gppk/EMF-Logo-Broach/Media/BOM Layout 1-crop-annotated.png

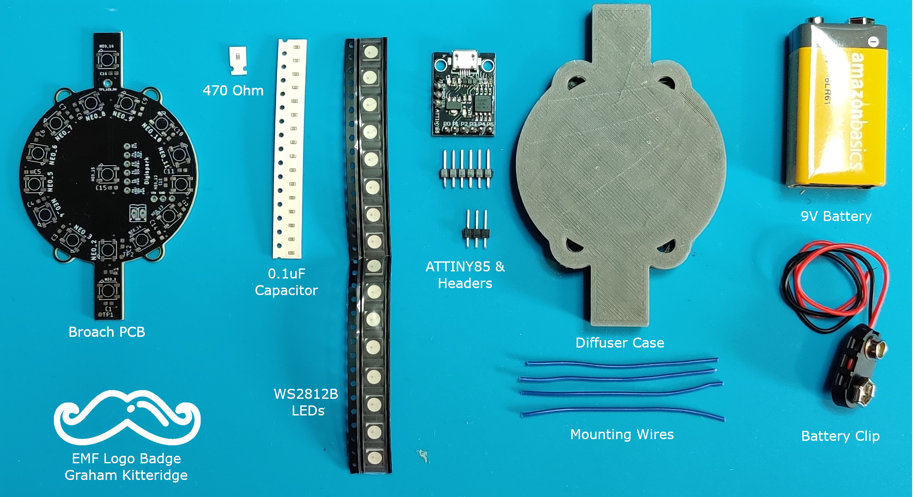
Media/BOM Layout 1-crop-annotated.png
