gppk/EMF-Logo-Broach/Kits/Kit Front Page.docx

EMF Logo Broach

https://blog.gppk.dev/emf-logo-badge-website/

1 | Broach PCB
1 | Broach Diffuser Case
1 | Digispark ATTINY85 & Headers
16 | WS2812B LEDs
16 | 0.1uF Capacitors
1 | 470 Ohm Resistor
1 | 9V Battery & Clip
4 | Mounting Wires
1 | Battery Sticker

EMF Logo Broach

https://blog.gppk.dev/emf-logo-badge-website/

1 | Broach PCB
1 | Broach Diffuser Case
1 | Digispark ATTINY85 & Headers
16 | WS2812B LEDs
16 | 0.1uF Capacitors
1 | 470 Ohm Resistor
1 | 9V Battery & Clip
4 | Mounting Wires
1 | Battery Sticker
