gppk/EMF-Logo-Broach/Hardware/EMF Badge/3D Printing Files/Diffuser Case.3mf

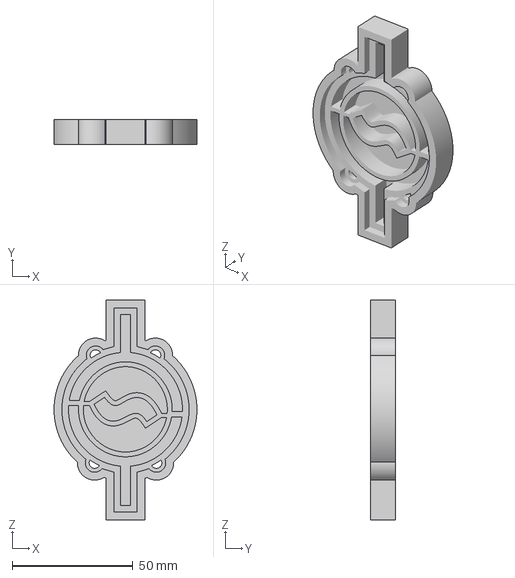
[picture p2: CAD file, 2022-05-13]
Hardware/EMF Badge/3D Printing Files/Diffuser Case.3mf
59.2 x 10.4 x 91.1 mm
