gppk/EMF-Logo-Broach/Hardware/EMF Badge/SolderStencil/pcb-stencil.3mf

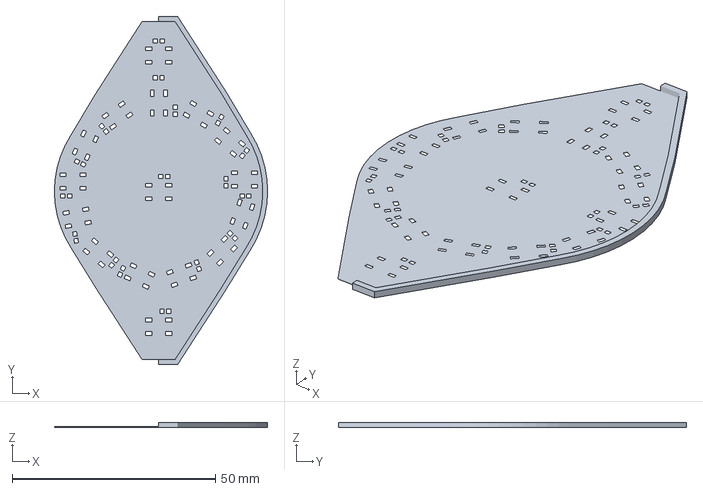
[picture p3: CAD file, 2022-05-13]
Hardware/EMF Badge/SolderStencil/pcb-stencil.3mf
52.4 x 85.5 x 1.20 mm
