gppk/EMF-Logo-Broach/Hardware/EMF Badge/SolderStencil/output.scad

rotate(a = 180, v = [1, 0, 0]) {
	union() {
		translate(v = [0, 0, -1.0000000000]) {
			linear_extrude(height = 1.2000000000) {
				difference() {
					polygon(points = [[20.9095670833, -1.2000000000], [30.3110361963, -1.2000000000], [42.2351863779, 17.3431679693], [48.3139464654, 27.5519898918], [49.7554900733, 30.1405903421], [50.9168166147, 32.9271457313], [51.7526695622, 35.8159708304], [52.2553940713, 38.7778560633], [52.4229252793, 41.7902765977], [52.2449729097, 44.8719929287], [51.7118517315, 47.9031377021], [50.8323147282, 50.8558690704], [49.6160567625, 53.6955488128], [48.1108870351, 56.3308836265], [41.8017726376, 66.5529519559], [41.6639389306, 66.7675195391], [30.3094091234, 84.3440000000], [20.9116971335, 84.3440000000], [9.4566744323, 66.6172726314], [3.0951645725, 56.3410208071], [1.5912865114, 53.7012458143], [0.3781252875, 50.8583244302], [-0.4972944317, 47.9043064544], [-1.0250720793, 44.8727265141], [-1.2019120014, 41.7900613624], [-1.0344018529, 38.7769725647], [-0.5317377234, 35.8123014176], [0.3041027405, 32.9193297869], [1.4666350095, 30.1302996677], [2.9095684429, 27.5420828811], [8.9654270859, 17.4009346347], [9.1044786186, 17.1785859001]]);
					polygon(points = [[21.5650000000, 0.0000000000], [29.6560000000, 0.0000000000], [41.2146915230, 17.9748455992], [47.2740000000, 28.1510000000], [48.6740000000, 30.6650000000], [49.7830000000, 33.3260000000], [50.5810000000, 36.0840000000], [51.0610000000, 38.9120000000], [51.2210000000, 41.7890000000], [51.0510000000, 44.7330000000], [50.5420000000, 47.6270000000], [49.7020000000, 50.4470000000], [48.5400000000, 53.1600000000], [47.0790000000, 55.7180000000], [40.7862936847, 65.9134838475], [40.6551366899, 66.1176577031], [29.6560000000, 83.1440000000], [21.5650000000, 83.1440000000], [10.4708676431, 65.9757529514], [4.1270000000, 55.7280000000], [2.6680000000, 53.1670000000], [1.5090000000, 50.4510000000], [0.6730000000, 47.6300000000], [0.1690000000, 44.7350000000], [0.0000000000, 41.7890000000], [0.1600000000, 38.9110000000], [0.6400000000, 36.0800000000], [1.4380000000, 33.3180000000], [2.5480000000, 30.6550000000], [3.9490000000, 28.1420000000], [9.9893888712, 18.0267574522], [10.1180571636, 17.8210119171]]);
					polygon(points = [[-1.2019120014, -1.2000000000], [-1.2019120014, 84.3440000000], [25.6105066389, 84.3440000000], [25.6105066389, -1.2000000000]]);
				}
			}
		}
		linear_extrude(height = 0.2000000000) {
			difference() {
				polygon(points = [[21.5650000000, 0.0000000000], [29.6560000000, 0.0000000000], [41.2146915230, 17.9748455992], [47.2740000000, 28.1510000000], [48.6740000000, 30.6650000000], [49.7830000000, 33.3260000000], [50.5810000000, 36.0840000000], [51.0610000000, 38.9120000000], [51.2210000000, 41.7890000000], [51.0510000000, 44.7330000000], [50.5420000000, 47.6270000000], [49.7020000000, 50.4470000000], [48.5400000000, 53.1600000000], [47.0790000000, 55.7180000000], [40.7862936847, 65.9134838475], [40.6551366899, 66.1176577031], [29.6560000000, 83.1440000000], [21.5650000000, 83.1440000000], [10.4708676431, 65.9757529514], [4.1270000000, 55.7280000000], [2.6680000000, 53.1670000000], [1.5090000000, 50.4510000000], [0.6730000000, 47.6300000000], [0.1690000000, 44.7350000000], [0.0000000000, 41.7890000000], [0.1600000000, 38.9110000000], [0.6400000000, 36.0800000000], [1.4380000000, 33.3180000000], [2.5480000000, 30.6550000000], [3.9490000000, 28.1420000000], [9.9893888712, 18.0267574522], [10.1180571636, 17.8210119171]]);
				union() {
					polygon(points = [[26.8740000000, 21.8110000000], [26.8740000000, 23.3110000000], [27.7740000000, 23.3110000000], [27.7740000000, 21.8110000000]]);
					polygon(points = [[23.5740000000, 21.8110000000], [23.5740000000, 23.3110000000], [24.4740000000, 23.3110000000], [24.4740000000, 21.8110000000]]);
					polygon(points = [[26.8740000000, 16.9110000000], [26.8740000000, 18.4110000000], [27.7740000000, 18.4110000000], [27.7740000000, 16.9110000000]]);
					polygon(points = [[23.5740000000, 16.9110000000], [23.5740000000, 18.4110000000], [24.4740000000, 18.4110000000], [24.4740000000, 16.9110000000]]);
					polygon(points = [[1.3720000000, 40.5700000000], [1.3720000000, 41.4700000000], [2.8720000000, 41.4700000000], [2.8720000000, 40.5700000000]]);
					polygon(points = [[1.3720000000, 37.2700000000], [1.3720000000, 38.1700000000], [2.8720000000, 38.1700000000], [2.8720000000, 37.2700000000]]);
					polygon(points = [[6.2720000000, 40.5700000000], [6.2720000000, 41.4700000000], [7.7720000000, 41.4700000000], [7.7720000000, 40.5700000000]]);
					polygon(points = [[6.2720000000, 37.2700000000], [6.2720000000, 38.1700000000], [7.7720000000, 38.1700000000], [7.7720000000, 37.2700000000]]);
					polygon(points = [[27.3540000000, 6.2820000000], [27.3540000000, 7.1820000000], [28.8540000000, 7.1820000000], [28.8540000000, 6.2820000000]]);
					polygon(points = [[27.3540000000, 9.5820000000], [27.3540000000, 10.4820000000], [28.8540000000, 10.4820000000], [28.8540000000, 9.5820000000]]);
					polygon(points = [[22.4540000000, 6.2820000000], [22.4540000000, 7.1820000000], [23.9540000000, 7.1820000000], [23.9540000000, 6.2820000000]]);
					polygon(points = [[22.4540000000, 9.5820000000], [22.4540000000, 10.4820000000], [23.9540000000, 10.4820000000], [23.9540000000, 9.5820000000]]);
					polygon(points = [[25.9540000000, 4.3260000000], [25.9540000000, 5.3260000000], [27.0540000000, 5.3260000000], [27.0540000000, 4.3260000000]]);
					polygon(points = [[24.2540000000, 4.3260000000], [24.2540000000, 5.3260000000], [25.3540000000, 5.3260000000], [25.3540000000, 4.3260000000]]);
					polygon(points = [[29.2180000000, 22.2710000000], [29.2180000000, 23.3710000000], [30.2180000000, 23.3710000000], [30.2180000000, 22.2710000000]]);
					polygon(points = [[29.2180000000, 20.5710000000], [29.2180000000, 21.6710000000], [30.2180000000, 21.6710000000], [30.2180000000, 20.5710000000]]);
					polygon(points = [[1.5210000000, 42.4260000000], [1.5210000000, 43.4260000000], [2.6210000000, 43.4260000000], [2.6210000000, 42.4260000000]]);
					polygon(points = [[3.2210000000, 42.4260000000], [3.2210000000, 43.4260000000], [4.3210000000, 43.4260000000], [4.3210000000, 42.4260000000]]);
					polygon(points = [[45.5900000000, 42.4260000000], [45.5900000000, 43.4260000000], [46.6900000000, 43.4260000000], [46.6900000000, 42.4260000000]]);
					polygon(points = [[47.2900000000, 42.4260000000], [47.2900000000, 43.4260000000], [48.3900000000, 43.4260000000], [48.3900000000, 42.4260000000]]);
					polygon(points = [[26.0040000000, 13.2930000000], [26.0040000000, 14.3930000000], [27.0040000000, 14.3930000000], [27.0040000000, 13.2930000000]]);
					polygon(points = [[24.3040000000, 13.2930000000], [24.3040000000, 14.3930000000], [25.3040000000, 14.3930000000], [25.3040000000, 13.2930000000]]);
					polygon(points = [[43.5360000000, 40.0620000000], [43.5360000000, 40.9620000000], [45.0360000000, 40.9620000000], [45.0360000000, 40.0620000000]]);
					polygon(points = [[43.5360000000, 36.7620000000], [43.5360000000, 37.6620000000], [45.0360000000, 37.6620000000], [45.0360000000, 36.7620000000]]);
					polygon(points = [[48.4360000000, 40.0620000000], [48.4360000000, 40.9620000000], [49.9360000000, 40.9620000000], [49.9360000000, 40.0620000000]]);
					polygon(points = [[48.4360000000, 36.7620000000], [48.4360000000, 37.6620000000], [49.9360000000, 37.6620000000], [49.9360000000, 36.7620000000]]);
					polygon(points = [[41.6640000000, 39.7970000000], [41.6640000000, 40.8970000000], [42.6640000000, 40.8970000000], [42.6640000000, 39.7970000000]]);
					polygon(points = [[41.6640000000, 38.0970000000], [41.6640000000, 39.1970000000], [42.6640000000, 39.1970000000], [42.6640000000, 38.0970000000]]);
					polygon(points = [[27.3540000000, 39.8100000000], [27.3540000000, 40.7100000000], [28.8540000000, 40.7100000000], [28.8540000000, 39.8100000000]]);
					polygon(points = [[27.3540000000, 43.1100000000], [27.3540000000, 44.0100000000], [28.8540000000, 44.0100000000], [28.8540000000, 43.1100000000]]);
					polygon(points = [[22.4540000000, 39.8100000000], [22.4540000000, 40.7100000000], [23.9540000000, 40.7100000000], [23.9540000000, 39.8100000000]]);
					polygon(points = [[22.4540000000, 43.1100000000], [22.4540000000, 44.0100000000], [23.9540000000, 44.0100000000], [23.9540000000, 43.1100000000]]);
					polygon(points = [[27.3510000000, 37.6000000000], [27.3510000000, 38.6000000000], [28.4510000000, 38.6000000000], [28.4510000000, 37.6000000000]]);
					polygon(points = [[25.6510000000, 37.6000000000], [25.6510000000, 38.6000000000], [26.7510000000, 38.6000000000], [26.7510000000, 37.6000000000]]);
					polygon(points = [[27.3540000000, 72.9570000000], [27.3540000000, 73.8570000000], [28.8540000000, 73.8570000000], [28.8540000000, 72.9570000000]]);
					polygon(points = [[27.3540000000, 76.2570000000], [27.3540000000, 77.1570000000], [28.8540000000, 77.1570000000], [28.8540000000, 76.2570000000]]);
					polygon(points = [[22.4540000000, 72.9570000000], [22.4540000000, 73.8570000000], [23.9540000000, 73.8570000000], [23.9540000000, 72.9570000000]]);
					polygon(points = [[22.4540000000, 76.2570000000], [22.4540000000, 77.1570000000], [23.9540000000, 77.1570000000], [23.9540000000, 76.2570000000]]);
					polygon(points = [[27.6050000000, 70.7470000000], [27.6050000000, 71.7470000000], [28.7050000000, 71.7470000000], [28.7050000000, 70.7470000000]]);
					polygon(points = [[25.9050000000, 70.7470000000], [25.9050000000, 71.7470000000], [27.0050000000, 71.7470000000], [27.0050000000, 70.7470000000]]);
					polygon(points = [[14.7900000000, 25.0720000000], [13.5610000000, 25.9320000000], [14.0770000000, 26.6700000000], [15.3060000000, 25.8090000000]]);
					polygon(points = [[12.8970000000, 22.3690000000], [11.6680000000, 23.2290000000], [12.1840000000, 23.9660000000], [13.4130000000, 23.1060000000]]);
					polygon(points = [[18.8030000000, 22.2620000000], [17.5750000000, 23.1220000000], [18.0910000000, 23.8590000000], [19.3200000000, 22.9990000000]]);
					polygon(points = [[16.9110000000, 19.5580000000], [15.6820000000, 20.4190000000], [16.1980000000, 21.1560000000], [17.4270000000, 20.2960000000]]);
					polygon(points = [[26.8740000000, 21.8110000000], [26.8740000000, 23.3110000000], [27.7740000000, 23.3110000000], [27.7740000000, 21.8110000000]]);
					polygon(points = [[23.5740000000, 21.8110000000], [23.5740000000, 23.3110000000], [24.4740000000, 23.3110000000], [24.4740000000, 21.8110000000]]);
					polygon(points = [[26.8740000000, 16.9110000000], [26.8740000000, 18.4110000000], [27.7740000000, 18.4110000000], [27.7740000000, 16.9110000000]]);
					polygon(points = [[23.5740000000, 16.9110000000], [23.5740000000, 18.4110000000], [24.4740000000, 18.4110000000], [24.4740000000, 16.9110000000]]);
					polygon(points = [[7.9890000000, 32.5280000000], [7.3550000000, 33.8870000000], [8.1710000000, 34.2680000000], [8.8050000000, 32.9080000000]]);
					polygon(points = [[4.9980000000, 31.1330000000], [4.3640000000, 32.4930000000], [5.1800000000, 32.8730000000], [5.8140000000, 31.5140000000]]);
					polygon(points = [[10.0600000000, 28.0870000000], [9.4260000000, 29.4460000000], [10.2420000000, 29.8270000000], [10.8760000000, 28.4670000000]]);
					polygon(points = [[7.0690000000, 26.6920000000], [6.4350000000, 28.0520000000], [7.2510000000, 28.4320000000], [7.8850000000, 27.0730000000]]);
					polygon(points = [[1.3720000000, 40.5700000000], [1.3720000000, 41.4700000000], [2.8720000000, 41.4700000000], [2.8720000000, 40.5700000000]]);
					polygon(points = [[1.3720000000, 37.2700000000], [1.3720000000, 38.1700000000], [2.8720000000, 38.1700000000], [2.8720000000, 37.2700000000]]);
					polygon(points = [[6.2720000000, 40.5700000000], [6.2720000000, 41.4700000000], [7.7720000000, 41.4700000000], [7.7720000000, 40.5700000000]]);
					polygon(points = [[6.2720000000, 37.2700000000], [6.2720000000, 38.1700000000], [7.7720000000, 38.1700000000], [7.7720000000, 37.2700000000]]);
					polygon(points = [[18.9070000000, 62.9800000000], [17.5480000000, 62.3460000000], [17.1670000000, 63.1620000000], [18.5270000000, 63.7960000000]]);
					polygon(points = [[20.3020000000, 59.9890000000], [18.9420000000, 59.3550000000], [18.5620000000, 60.1710000000], [19.9210000000, 60.8050000000]]);
					polygon(points = [[23.3480000000, 65.0510000000], [21.9890000000, 64.4170000000], [21.6080000000, 65.2330000000], [22.9680000000, 65.8670000000]]);
					polygon(points = [[24.7430000000, 62.0600000000], [23.3830000000, 61.4260000000], [23.0030000000, 62.2420000000], [24.3620000000, 62.8760000000]]);
					polygon(points = [[12.8690000000, 57.0700000000], [14.0180000000, 58.0340000000], [14.5960000000, 57.3440000000], [13.4470000000, 56.3800000000]]);
					polygon(points = [[10.7480000000, 59.5970000000], [11.8960000000, 60.5620000000], [12.4750000000, 59.8720000000], [11.3260000000, 58.9080000000]]);
					polygon(points = [[9.1150000000, 53.9200000000], [10.2640000000, 54.8840000000], [10.8420000000, 54.1940000000], [9.6940000000, 53.2300000000]]);
					polygon(points = [[6.9940000000, 56.4480000000], [8.1430000000, 57.4120000000], [8.7210000000, 56.7220000000], [7.5720000000, 55.7580000000]]);
					polygon(points = [[32.4290000000, 60.6480000000], [33.8390000000, 60.1350000000], [33.5310000000, 59.2890000000], [32.1210000000, 59.8020000000]]);
					polygon(points = [[33.5580000000, 63.7490000000], [34.9670000000, 63.2360000000], [34.6590000000, 62.3900000000], [33.2500000000, 62.9030000000]]);
					polygon(points = [[27.8250000000, 62.3240000000], [29.2340000000, 61.8110000000], [28.9260000000, 60.9650000000], [27.5170000000, 61.4780000000]]);
					polygon(points = [[28.9530000000, 65.4250000000], [30.3630000000, 64.9120000000], [30.0550000000, 64.0660000000], [28.6450000000, 64.5790000000]]);
					polygon(points = [[41.6290000000, 54.3370000000], [42.6890000000, 53.2770000000], [42.0530000000, 52.6400000000], [40.9920000000, 53.7010000000]]);
					polygon(points = [[43.9620000000, 56.6710000000], [45.0230000000, 55.6100000000], [44.3860000000, 54.9740000000], [43.3260000000, 56.0340000000]]);
					polygon(points = [[38.1640000000, 57.8020000000], [39.2240000000, 56.7420000000], [38.5880000000, 56.1050000000], [37.5270000000, 57.1660000000]]);
					polygon(points = [[40.4970000000, 60.1360000000], [41.5580000000, 59.0750000000], [40.9210000000, 58.4390000000], [39.8610000000, 59.4990000000]]);
					polygon(points = [[27.3540000000, 6.2820000000], [27.3540000000, 7.1820000000], [28.8540000000, 7.1820000000], [28.8540000000, 6.2820000000]]);
					polygon(points = [[27.3540000000, 9.5820000000], [27.3540000000, 10.4820000000], [28.8540000000, 10.4820000000], [28.8540000000, 9.5820000000]]);
					polygon(points = [[22.4540000000, 6.2820000000], [22.4540000000, 7.1820000000], [23.9540000000, 7.1820000000], [23.9540000000, 6.2820000000]]);
					polygon(points = [[22.4540000000, 9.5820000000], [22.4540000000, 10.4820000000], [23.9540000000, 10.4820000000], [23.9540000000, 9.5820000000]]);
					polygon(points = [[4.1220000000, 49.7370000000], [2.6450000000, 49.9980000000], [2.8010000000, 50.8840000000], [4.2780000000, 50.6230000000]]);
					polygon(points = [[3.5490000000, 46.4870000000], [2.0720000000, 46.7480000000], [2.2280000000, 47.6340000000], [3.7050000000, 47.3730000000]]);
					polygon(points = [[8.9480000000, 48.8860000000], [7.4710000000, 49.1470000000], [7.6270000000, 50.0330000000], [9.1040000000, 49.7720000000]]);
					polygon(points = [[8.3750000000, 45.6360000000], [6.8980000000, 45.8970000000], [7.0540000000, 46.7830000000], [8.5310000000, 46.5230000000]]);
					polygon(points = [[45.6820000000, 45.3630000000], [46.1950000000, 43.9540000000], [45.3490000000, 43.6460000000], [44.8360000000, 45.0550000000]]);
					polygon(points = [[48.7830000000, 46.4920000000], [49.2960000000, 45.0820000000], [48.4500000000, 44.7750000000], [47.9370000000, 46.1840000000]]);
					polygon(points = [[44.0060000000, 49.9680000000], [44.5190000000, 48.5580000000], [43.6730000000, 48.2500000000], [43.1600000000, 49.6600000000]]);
					polygon(points = [[47.1070000000, 51.0960000000], [47.6200000000, 49.6870000000], [46.7740000000, 49.3790000000], [46.2610000000, 50.7880000000]]);
					polygon(points = [[25.9540000000, 4.3260000000], [25.9540000000, 5.3260000000], [27.0540000000, 5.3260000000], [27.0540000000, 4.3260000000]]);
					polygon(points = [[24.2540000000, 4.3260000000], [24.2540000000, 5.3260000000], [25.3540000000, 5.3260000000], [25.3540000000, 4.3260000000]]);
					polygon(points = [[29.2180000000, 22.2710000000], [29.2180000000, 23.3710000000], [30.2180000000, 23.3710000000], [30.2180000000, 22.2710000000]]);
					polygon(points = [[29.2180000000, 20.5710000000], [29.2180000000, 21.6710000000], [30.2180000000, 21.6710000000], [30.2180000000, 20.5710000000]]);
					polygon(points = [[11.9920000000, 26.9640000000], [12.6840000000, 27.8190000000], [13.4610000000, 27.1890000000], [12.7690000000, 26.3350000000]]);
					polygon(points = [[10.9220000000, 25.6430000000], [11.6150000000, 26.4970000000], [12.3920000000, 25.8680000000], [11.7000000000, 25.0130000000]]);
					polygon(points = [[6.4110000000, 35.3780000000], [7.4070000000, 35.8430000000], [7.8300000000, 34.9370000000], [6.8330000000, 34.4720000000]]);
					polygon(points = [[4.8700000000, 34.6600000000], [5.8670000000, 35.1240000000], [6.2890000000, 34.2180000000], [5.2930000000, 33.7530000000]]);
					polygon(points = [[1.5210000000, 42.4260000000], [1.5210000000, 43.4260000000], [2.6210000000, 43.4260000000], [2.6210000000, 42.4260000000]]);
					polygon(points = [[3.2210000000, 42.4260000000], [3.2210000000, 43.4260000000], [4.3210000000, 43.4260000000], [4.3210000000, 42.4260000000]]);
					polygon(points = [[5.6470000000, 52.7040000000], [5.4560000000, 51.6200000000], [4.4710000000, 51.7940000000], [4.6630000000, 52.8770000000]]);
					polygon(points = [[5.9420000000, 54.3780000000], [5.7510000000, 53.2950000000], [4.7670000000, 53.4680000000], [4.9580000000, 54.5510000000]]);
					polygon(points = [[15.1810000000, 59.4010000000], [15.8880000000, 58.5580000000], [15.1220000000, 57.9150000000], [14.4150000000, 58.7580000000]]);
					polygon(points = [[14.0880000000, 60.7030000000], [14.7950000000, 59.8600000000], [14.0290000000, 59.2170000000], [13.3220000000, 60.0600000000]]);
					polygon(points = [[15.9300000000, 61.5290000000], [15.4650000000, 62.5260000000], [16.3720000000, 62.9480000000], [16.8360000000, 61.9510000000]]);
					polygon(points = [[16.6480000000, 59.9880000000], [16.1840000000, 60.9850000000], [17.0900000000, 61.4070000000], [17.5550000000, 60.4100000000]]);
					polygon(points = [[35.6410000000, 59.5940000000], [35.2650000000, 58.5610000000], [34.3250000000, 58.9030000000], [34.7010000000, 59.9370000000]]);
					polygon(points = [[36.2220000000, 61.1920000000], [35.8460000000, 60.1580000000], [34.9070000000, 60.5000000000], [35.2830000000, 61.5340000000]]);
					polygon(points = [[43.9330000000, 52.1600000000], [43.1560000000, 51.3830000000], [42.4490000000, 52.0900000000], [43.2260000000, 52.8670000000]]);
					polygon(points = [[45.1350000000, 53.3620000000], [44.3580000000, 52.5850000000], [43.6510000000, 53.2920000000], [44.4280000000, 54.0700000000]]);
					polygon(points = [[45.5900000000, 42.4260000000], [45.5900000000, 43.4260000000], [46.6900000000, 43.4260000000], [46.6900000000, 42.4260000000]]);
					polygon(points = [[47.2900000000, 42.4260000000], [47.2900000000, 43.4260000000], [48.3900000000, 43.4260000000], [48.3900000000, 42.4260000000]]);
					polygon(points = [[26.0040000000, 13.2930000000], [26.0040000000, 14.3930000000], [27.0040000000, 14.3930000000], [27.0040000000, 13.2930000000]]);
					polygon(points = [[24.3040000000, 13.2930000000], [24.3040000000, 14.3930000000], [25.3040000000, 14.3930000000], [25.3040000000, 13.2930000000]]);
					polygon(points = [[43.5360000000, 40.0620000000], [43.5360000000, 40.9620000000], [45.0360000000, 40.9620000000], [45.0360000000, 40.0620000000]]);
					polygon(points = [[43.5360000000, 36.7620000000], [43.5360000000, 37.6620000000], [45.0360000000, 37.6620000000], [45.0360000000, 36.7620000000]]);
					polygon(points = [[48.4360000000, 40.0620000000], [48.4360000000, 40.9620000000], [49.9360000000, 40.9620000000], [49.9360000000, 40.0620000000]]);
					polygon(points = [[48.4360000000, 36.7620000000], [48.4360000000, 37.6620000000], [49.9360000000, 37.6620000000], [49.9360000000, 36.7620000000]]);
					polygon(points = [[41.6640000000, 39.7970000000], [41.6640000000, 40.8970000000], [42.6640000000, 40.8970000000], [42.6640000000, 39.7970000000]]);
					polygon(points = [[41.6640000000, 38.0970000000], [41.6640000000, 39.1970000000], [42.6640000000, 39.1970000000], [42.6640000000, 38.0970000000]]);
					polygon(points = [[45.2540000000, 29.8920000000], [46.4030000000, 30.8560000000], [46.9810000000, 30.1660000000], [45.8320000000, 29.2020000000]]);
					polygon(points = [[43.1330000000, 32.4190000000], [44.2810000000, 33.3840000000], [44.8600000000, 32.6940000000], [43.7110000000, 31.7300000000]]);
					polygon(points = [[41.5000000000, 26.7420000000], [42.6490000000, 27.7060000000], [43.2270000000, 27.0170000000], [42.0790000000, 26.0520000000]]);
					polygon(points = [[39.3790000000, 29.2700000000], [40.5280000000, 30.2340000000], [41.1060000000, 29.5440000000], [39.9570000000, 28.5800000000]]);
					polygon(points = [[47.3120000000, 32.4770000000], [48.0190000000, 31.6340000000], [47.2530000000, 30.9910000000], [46.5460000000, 31.8340000000]]);
					polygon(points = [[46.2190000000, 33.7790000000], [46.9260000000, 32.9360000000], [46.1600000000, 32.2930000000], [45.4530000000, 33.1360000000]]);
					polygon(points = [[37.5050000000, 22.6710000000], [38.8040000000, 23.4210000000], [39.2540000000, 22.6410000000], [37.9550000000, 21.8910000000]]);
					polygon(points = [[35.8550000000, 25.5290000000], [37.1540000000, 26.2790000000], [37.6040000000, 25.4990000000], [36.3050000000, 24.7490000000]]);
					polygon(points = [[33.2620000000, 20.2210000000], [34.5610000000, 20.9710000000], [35.0110000000, 20.1910000000], [33.7120000000, 19.4410000000]]);
					polygon(points = [[31.6120000000, 23.0790000000], [32.9110000000, 23.8290000000], [33.3610000000, 23.0490000000], [32.0620000000, 22.2990000000]]);
					polygon(points = [[41.2230000000, 24.2470000000], [41.7730000000, 23.2950000000], [40.9070000000, 22.7950000000], [40.3570000000, 23.7470000000]]);
					polygon(points = [[40.3730000000, 25.7190000000], [40.9230000000, 24.7670000000], [40.0570000000, 24.2670000000], [39.5070000000, 25.2190000000]]);
					polygon(points = [[27.3540000000, 39.8100000000], [27.3540000000, 40.7100000000], [28.8540000000, 40.7100000000], [28.8540000000, 39.8100000000]]);
					polygon(points = [[27.3540000000, 43.1100000000], [27.3540000000, 44.0100000000], [28.8540000000, 44.0100000000], [28.8540000000, 43.1100000000]]);
					polygon(points = [[22.4540000000, 39.8100000000], [22.4540000000, 40.7100000000], [23.9540000000, 40.7100000000], [23.9540000000, 39.8100000000]]);
					polygon(points = [[22.4540000000, 43.1100000000], [22.4540000000, 44.0100000000], [23.9540000000, 44.0100000000], [23.9540000000, 43.1100000000]]);
					polygon(points = [[27.3510000000, 37.6000000000], [27.3510000000, 38.6000000000], [28.4510000000, 38.6000000000], [28.4510000000, 37.6000000000]]);
					polygon(points = [[25.6510000000, 37.6000000000], [25.6510000000, 38.6000000000], [26.7510000000, 38.6000000000], [26.7510000000, 37.6000000000]]);
					polygon(points = [[27.3540000000, 72.9570000000], [27.3540000000, 73.8570000000], [28.8540000000, 73.8570000000], [28.8540000000, 72.9570000000]]);
					polygon(points = [[27.3540000000, 76.2570000000], [27.3540000000, 77.1570000000], [28.8540000000, 77.1570000000], [28.8540000000, 76.2570000000]]);
					polygon(points = [[22.4540000000, 72.9570000000], [22.4540000000, 73.8570000000], [23.9540000000, 73.8570000000], [23.9540000000, 72.9570000000]]);
					polygon(points = [[22.4540000000, 76.2570000000], [22.4540000000, 77.1570000000], [23.9540000000, 77.1570000000], [23.9540000000, 76.2570000000]]);
					polygon(points = [[27.6050000000, 70.7470000000], [27.6050000000, 71.7470000000], [28.7050000000, 71.7470000000], [28.7050000000, 70.7470000000]]);
					polygon(points = [[25.9050000000, 70.7470000000], [25.9050000000, 71.7470000000], [27.0050000000, 71.7470000000], [27.0050000000, 70.7470000000]]);
				}
			}
		}
	}
}
