gppk/EMF-Logo-Broach/Hardware/EMF Badge/PDFs/EMF Broach-PCB.pdf

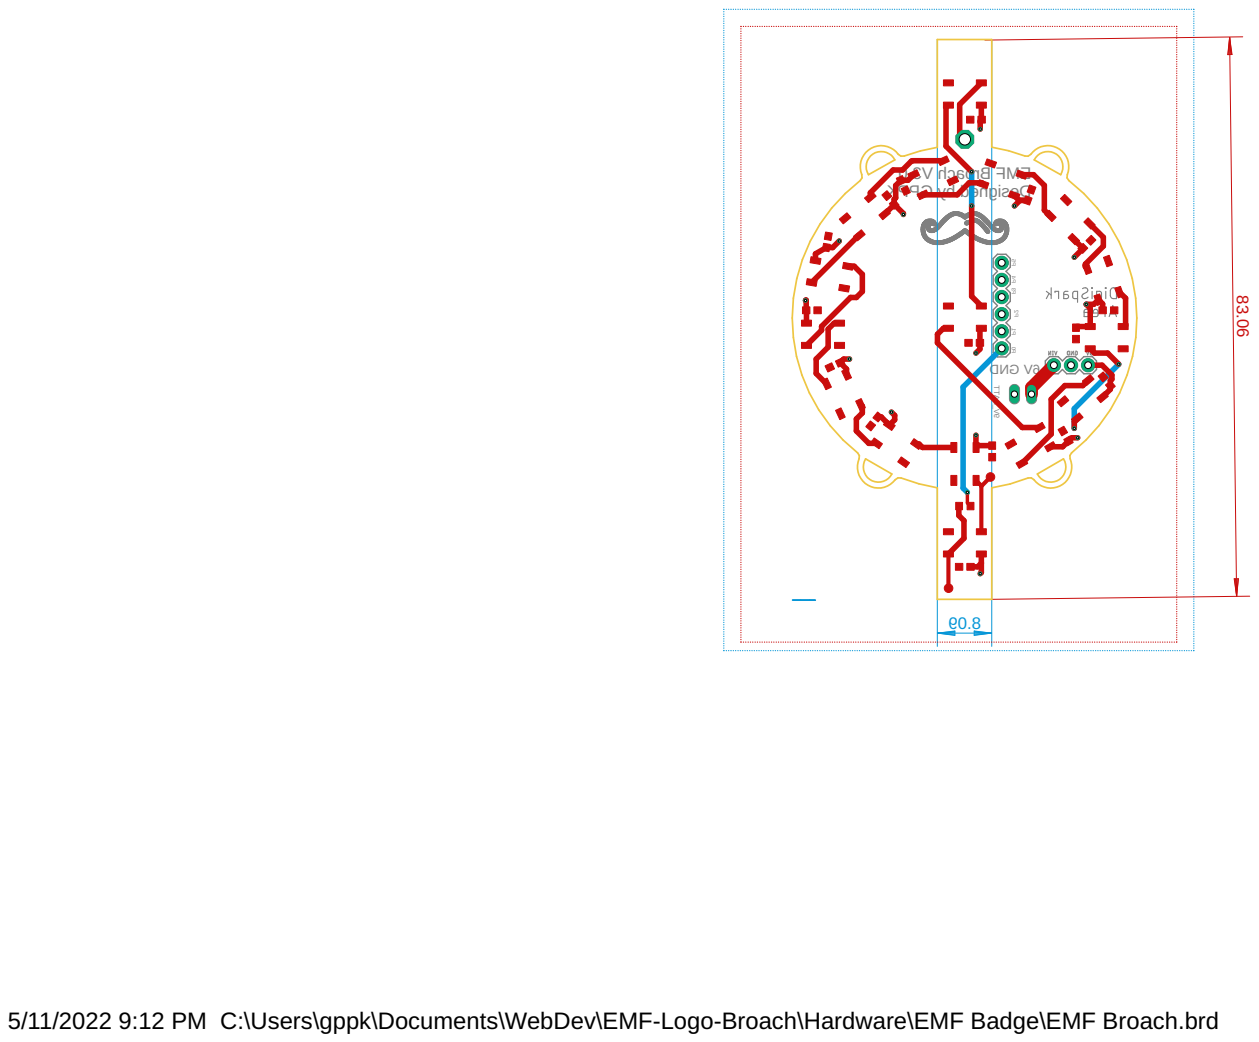
[picture p4: page 1]

5/11/2022 9:12 PM C:\Users\gppk\Documents\WebDev\EMF-Logo-Broach\Hardware\EMF Badge\EMF Broach.brd
