gppk/EMF-Logo-Broach/Hardware/EMF Badge/PDFs/EMF Broach-schematic.pdf

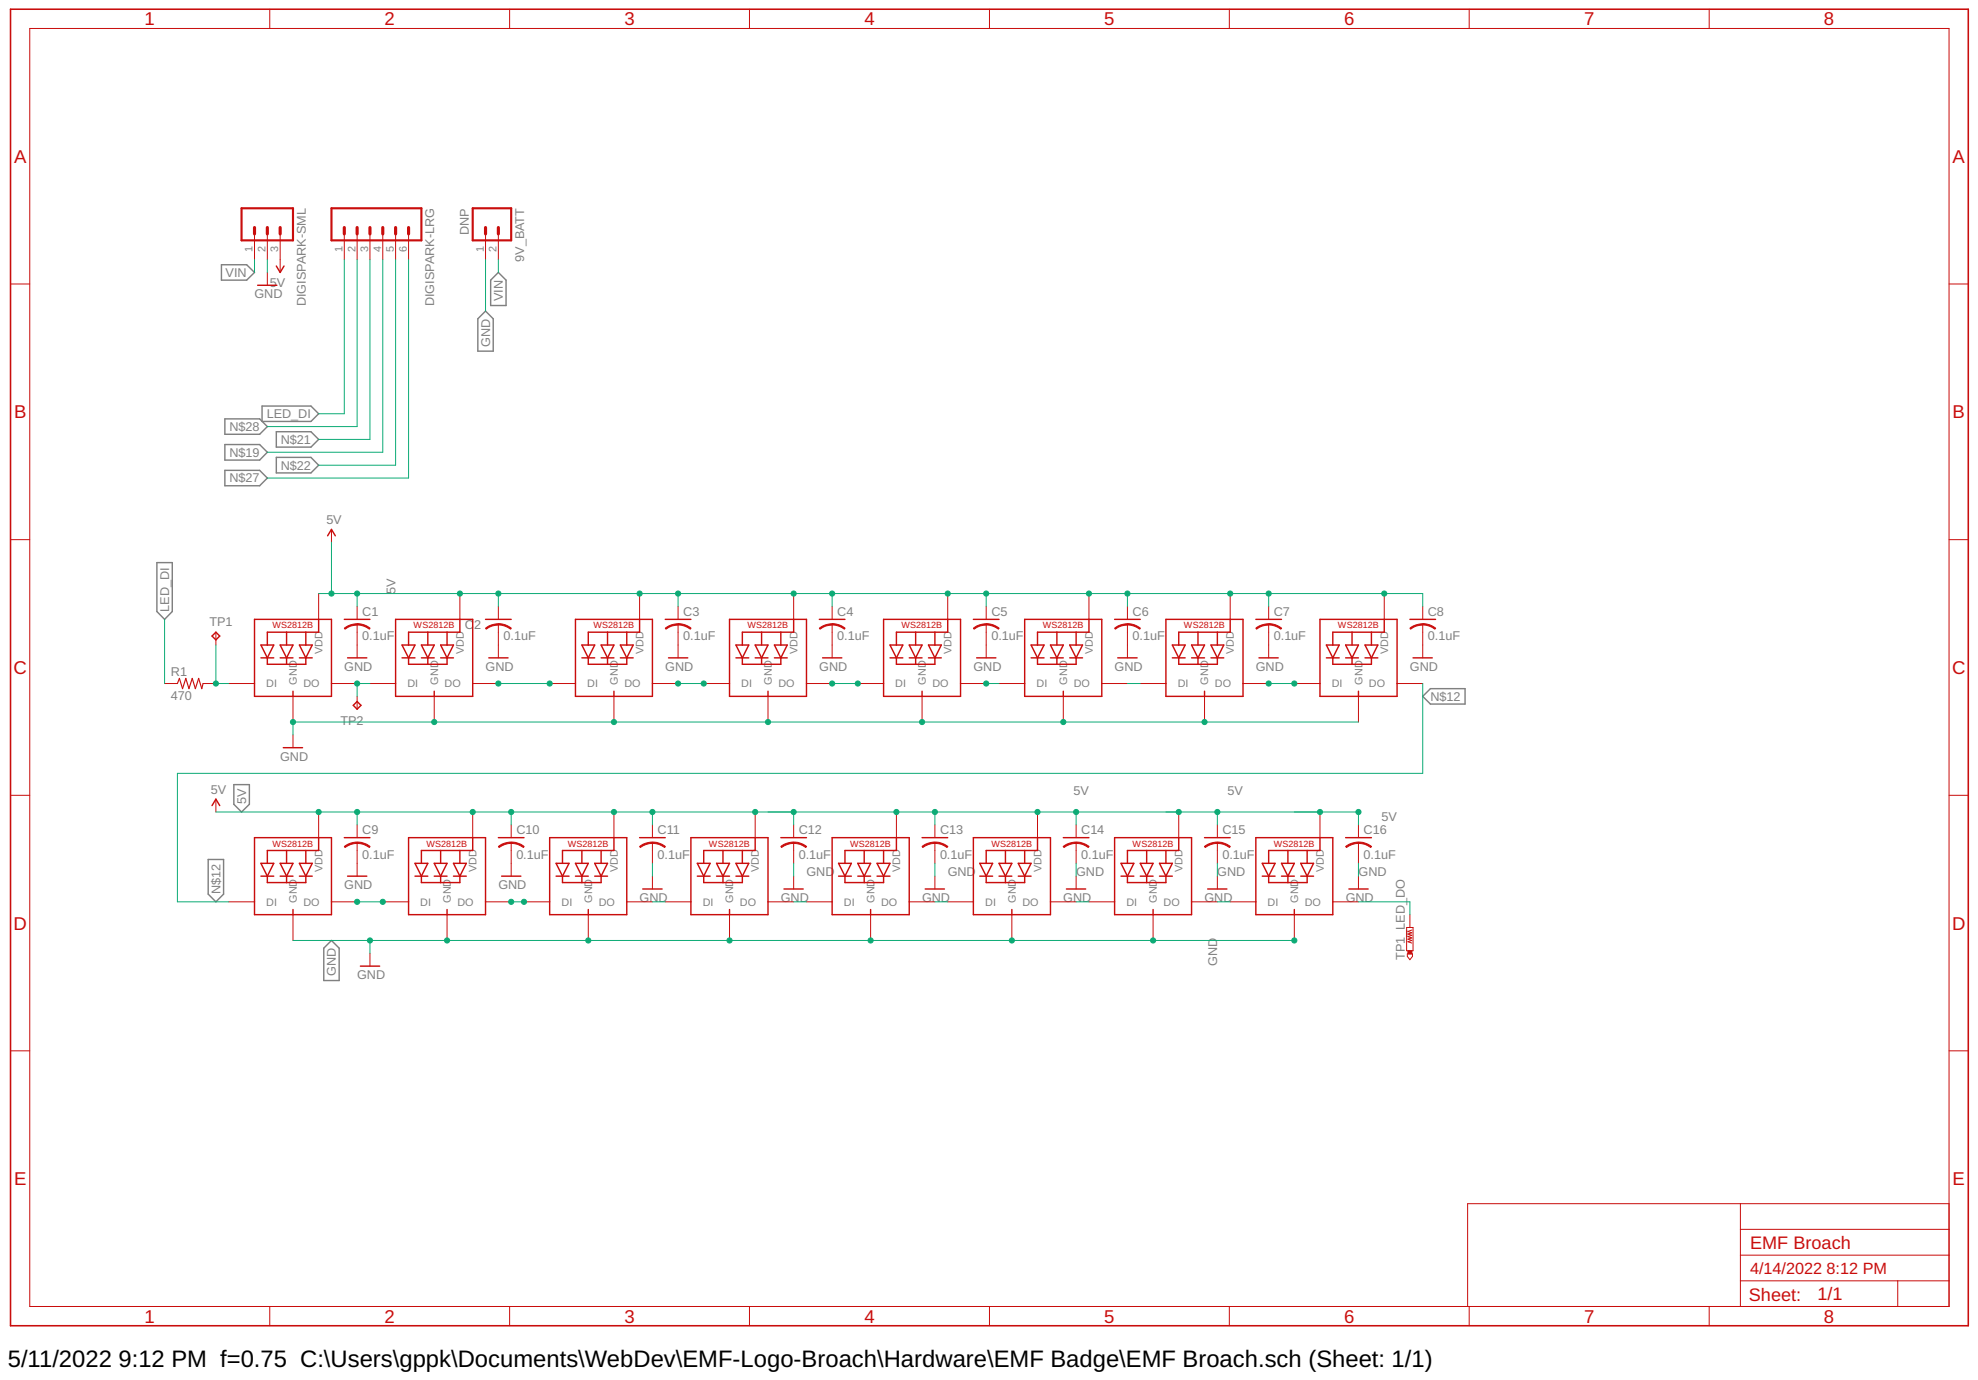
[picture p5: page 1]

5/11/2022 9:12 PM f=0.75 C:\Users\gppk\Documents\WebDev\EMF-Logo-Broach\Hardware\EMF Badge\EMF Broach.sch (Sheet: 1/1)
