gppk/EMF-Logo-Broach/Hardware/EMF Badge/EMF Broach.brd

## EAGLE design Hardware/EMF Badge/EMF Broach.brd (2022-05-13)

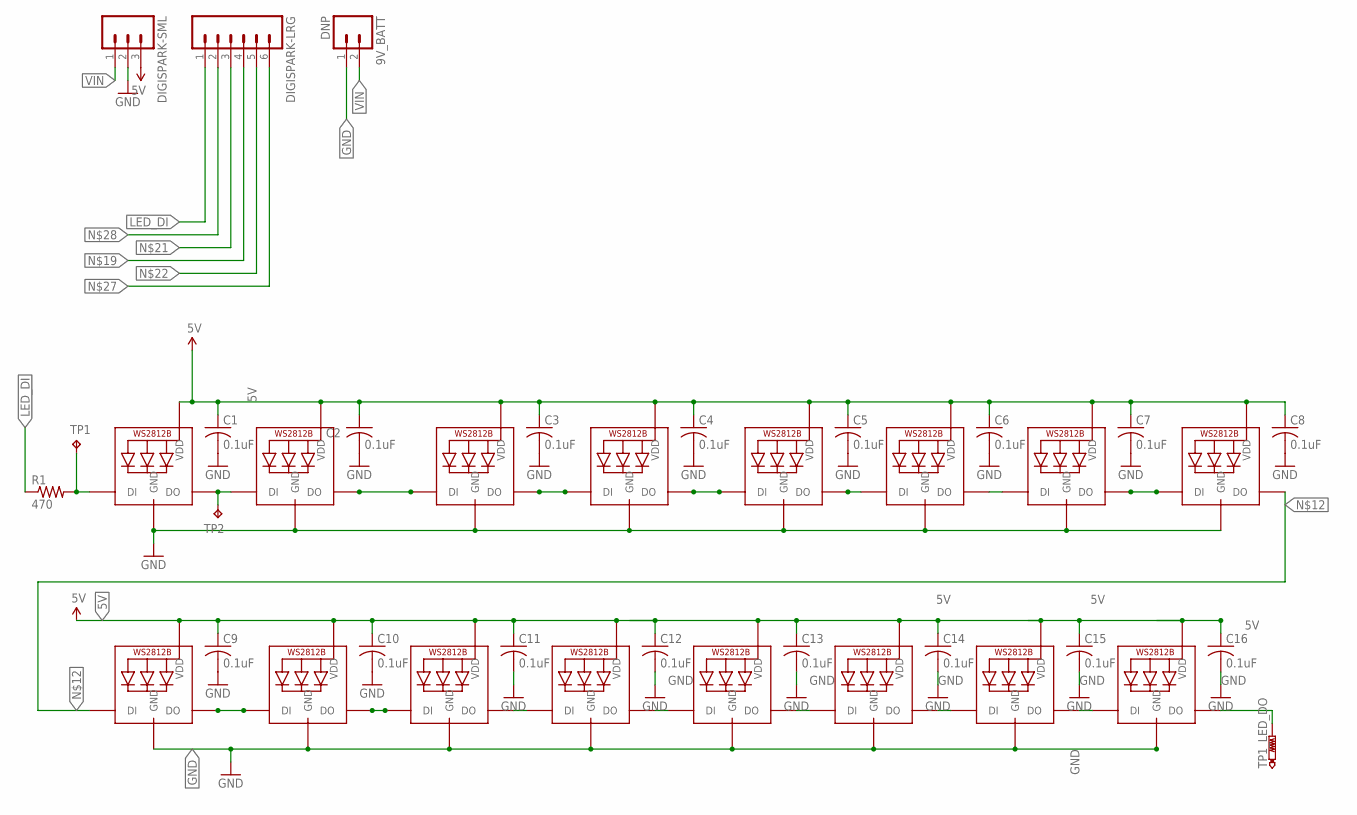
[picture p6: schematic EMF Broach.sch]

Parts:
9V_BATT: DNP; 02P
C1, C2, C3, C4, C5, C6, C7, C8, C9, C10, C11, C12, C13, C14, C15, C16: 0.1uF; C0603
DIGISPARK-LRG: M06SIP; 1X06
DIGISPARK-SML: M03PTH; 1X03
NEO_1, NEO_2, NEO_3, NEO_4, NEO_5, NEO_6, NEO_7, NEO_8, NEO_9, NEO_10, NEO_11, NEO_12, NEO_13, NEO_14, NEO_15, NEO_16: WS2812B5050; WS2812B
R1: 470; R0603
TP1, TP2: TPB1,27; B1,27
TP1_LED_DO: PTR1PAD1-17; P1-17

Connections:
5V: C1.1, C2.1, C3.1, C4.1, C5.1, C6.1, C7.1, C8.1, C9.1, C10.1, C11.1, C12.1, C13.1, C14.1, C15.1, C16.1, DIGISPARK-SML.3, NEO_1.1-VDD (VDD), NEO_2.1-VDD (VDD), NEO_3.1-VDD (VDD), NEO_4.1-VDD (VDD), NEO_5.1-VDD (VDD), NEO_6.1-VDD (VDD), NEO_7.1-VDD (VDD), NEO_8.1-VDD (VDD), NEO_9.1-VDD (VDD), NEO_10.1-VDD (VDD), NEO_11.1-VDD (VDD), NEO_12.1-VDD (VDD), NEO_13.1-VDD (VDD), NEO_14.1-VDD (VDD), NEO_15.1-VDD (VDD), NEO_16.1-VDD (VDD)
GND: 9V_BATT.1, C1.2, C2.2, C3.2, C4.2, C5.2, C6.2, C7.2, C8.2, C9.2, C10.2, C11.2, C12.2, C13.2, C14.2, C15.2, C16.2, DIGISPARK-SML.2, NEO_1.3-GND (GND), NEO_2.3-GND (GND), NEO_3.3-GND (GND), NEO_4.3-GND (GND), NEO_5.3-GND (GND), NEO_6.3-GND (GND), NEO_7.3-GND (GND), NEO_8.3-GND (GND), NEO_9.3-GND (GND), NEO_10.3-GND (GND), NEO_11.3-GND (GND), NEO_12.3-GND (GND), NEO_13.3-GND (GND), NEO_14.3-GND (GND), NEO_15.3-GND (GND), NEO_16.3-GND (GND)
LED_DI: DIGISPARK-LRG.1, R1.1
unnamed: NEO_1.2-DOUT (DO), NEO_2.4-DIN (DI), TP2.TP
unnamed: NEO_2.2-DOUT (DO), NEO_3.4-DIN (DI)
unnamed: NEO_10.2-DOUT (DO), NEO_11.4-DIN (DI)
unnamed: NEO_6.2-DOUT (DO), NEO_7.4-DIN (DI)
unnamed: NEO_7.2-DOUT (DO), NEO_8.4-DIN (DI)
unnamed: NEO_1.4-DIN (DI), R1.2, TP1.TP
unnamed: NEO_3.2-DOUT (DO), NEO_4.4-DIN (DI)
unnamed: NEO_4.2-DOUT (DO), NEO_5.4-DIN (DI)
unnamed: NEO_5.2-DOUT (DO), NEO_6.4-DIN (DI)
unnamed: NEO_8.2-DOUT (DO), NEO_9.4-DIN (DI)
unnamed: NEO_11.2-DOUT (DO), NEO_12.4-DIN (DI)
unnamed: NEO_9.2-DOUT (DO), NEO_10.4-DIN (DI)
unnamed: NEO_13.2-DOUT (DO), NEO_14.4-DIN (DI)
unnamed: NEO_15.2-DOUT (DO), NEO_16.4-DIN (DI)
unnamed: NEO_14.2-DOUT (DO), NEO_15.4-DIN (DI)
unnamed: NEO_12.2-DOUT (DO), NEO_13.4-DIN (DI)
unnamed: NEO_16.2-DOUT (DO), TP1_LED_DO.TP
VIN: 9V_BATT.2, DIGISPARK-SML.1

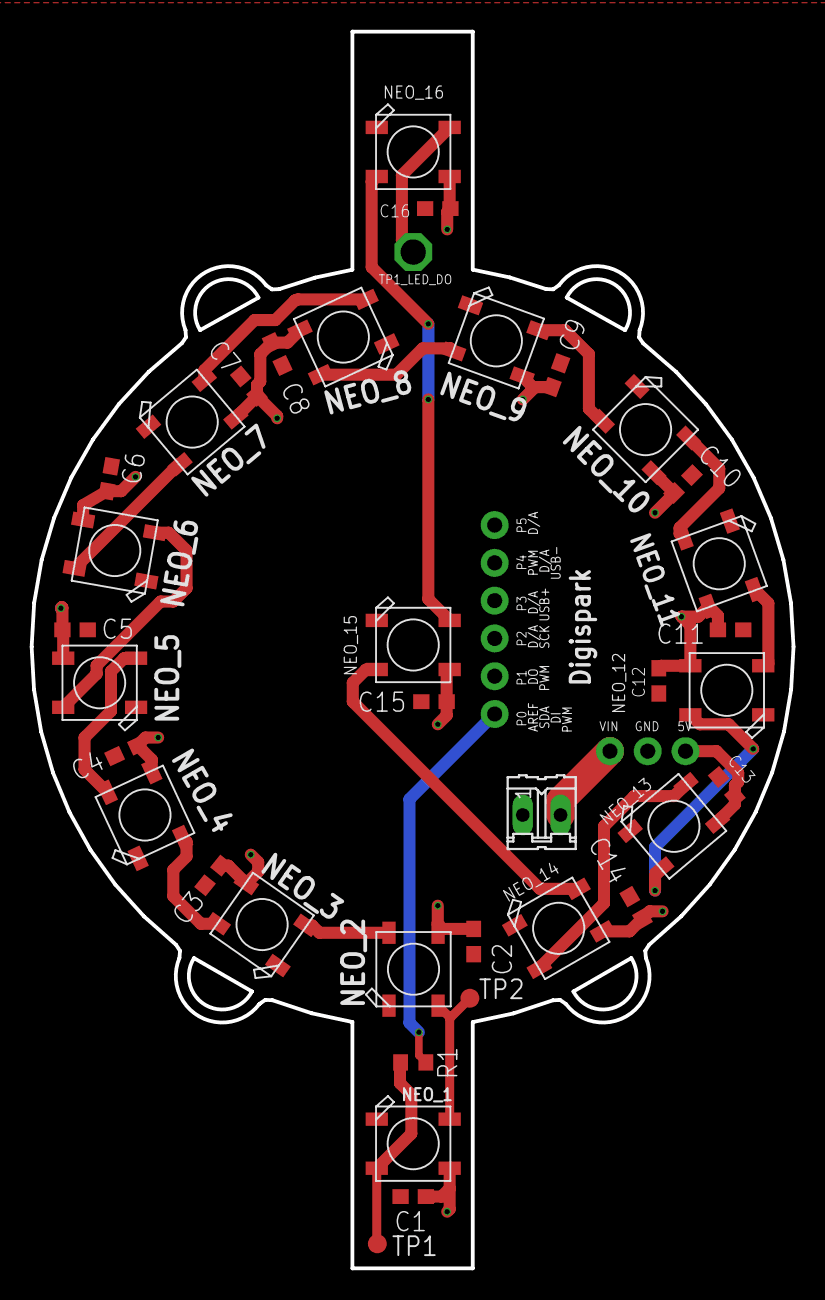
[picture p7: board EMF Broach.brd from above]

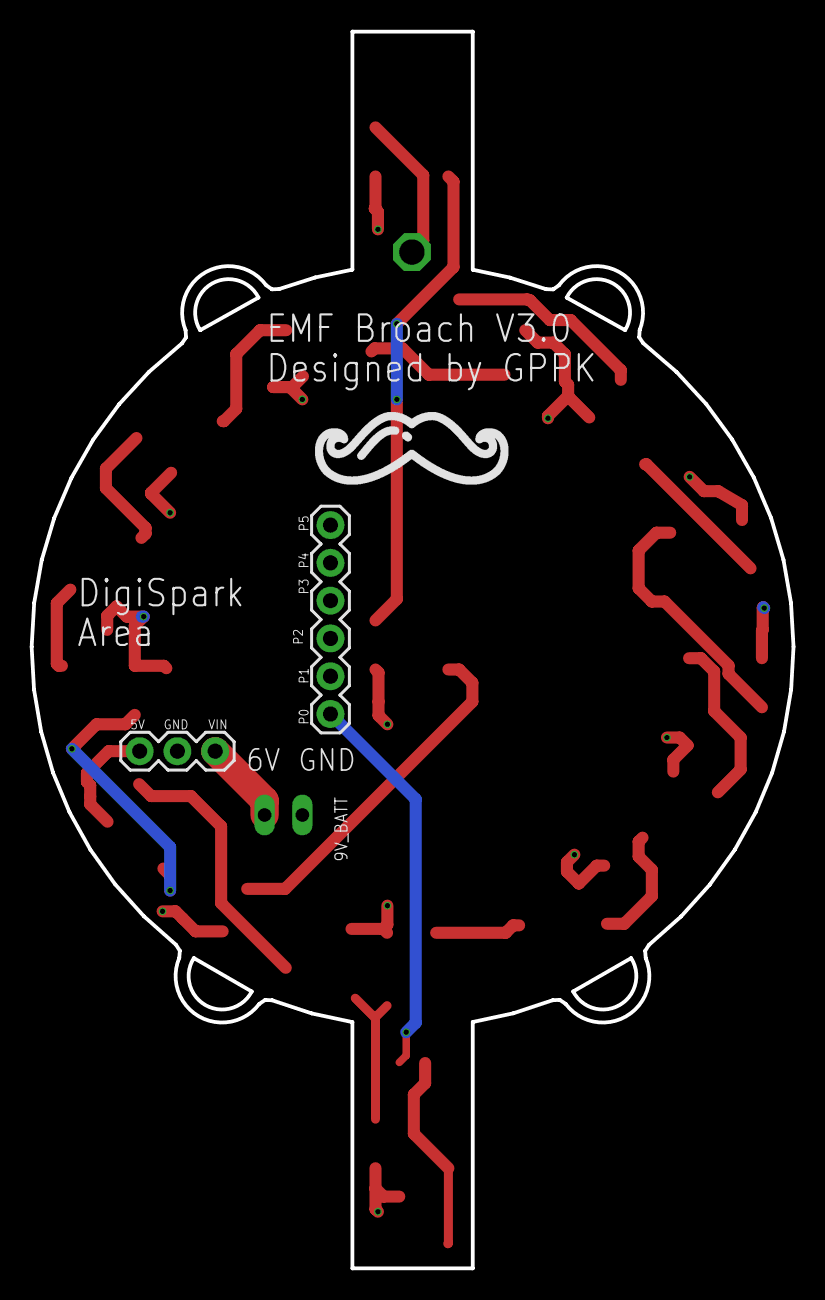
[picture p8: board EMF Broach.brd from below]

Board: 2 copper layers, 51.2 x 83.1 mm, 39 parts (2 on the bottom side), 21 nets.
