gppk/EMF-Logo-Broach/EMF Broach V1.0.brd

## EAGLE design EMF Broach V1.0.brd (2019-12-24)

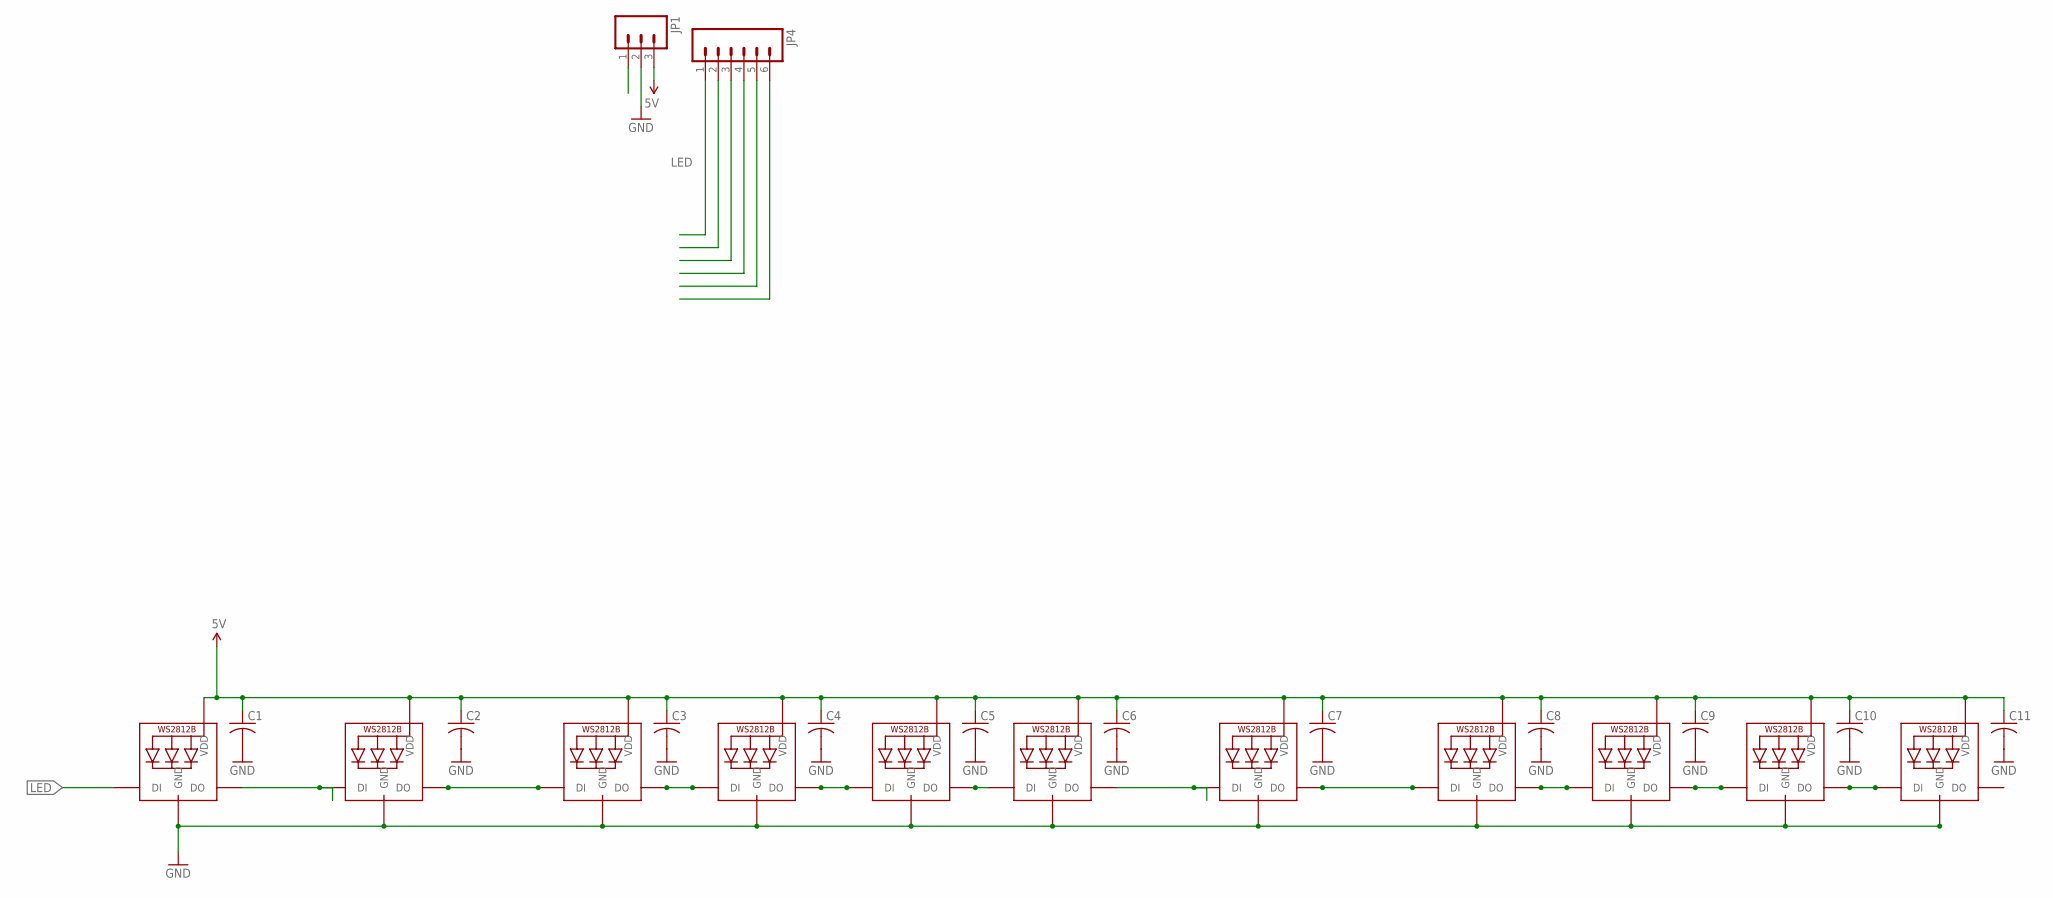
[picture p9: schematic EMF Broach V1.0.sch]

Parts:
C1, C2, C3, C4, C5, C6, C7, C8, C9, C10, C11: C-USC0603; C0603
JP1: M03PTH; 1X03
JP4: M06SIP; 1X06
L1, L2, L3, L4, L5, L6, L7, L8, L9, L10, L11: WS2812B3535; LED3535

Connections:
5V: C1.1, C2.1, C3.1, C4.1, C5.1, C6.1, C7.1, C8.1, C9.1, C10.1, C11.1, JP1.3, L1.2 (VDD), L2.2 (VDD), L3.2 (VDD), L4.2 (VDD), L5.2 (VDD), L6.2 (VDD), L7.2 (VDD), L8.2 (VDD), L9.2 (VDD), L10.2 (VDD), L11.2 (VDD)
GND: C1.2, C2.2, C3.2, C4.2, C5.2, C6.2, C7.2, C8.2, C9.2, C10.2, C11.2, JP1.2, L1.4 (GND), L2.4 (GND), L3.4 (GND), L4.4 (GND), L5.4 (GND), L6.4 (GND), L7.4 (GND), L8.4 (GND), L9.4 (GND), L10.4 (GND), L11.4 (GND)
LED: JP4.1, L1.1 (DI)
unnamed: L1.3 (DO), L2.1 (DI)
unnamed: L2.3 (DO), L3.1 (DI)
unnamed: L10.3 (DO), L11.1 (DI)
unnamed: L7.3 (DO), L8.1 (DI)
unnamed: L6.3 (DO), L7.1 (DI)
unnamed: L3.3 (DO), L4.1 (DI)
unnamed: L4.3 (DO), L5.1 (DI)
unnamed: L5.3 (DO), L6.1 (DI)
unnamed: L8.3 (DO), L9.1 (DI)
unnamed: L9.3 (DO), L10.1 (DI)

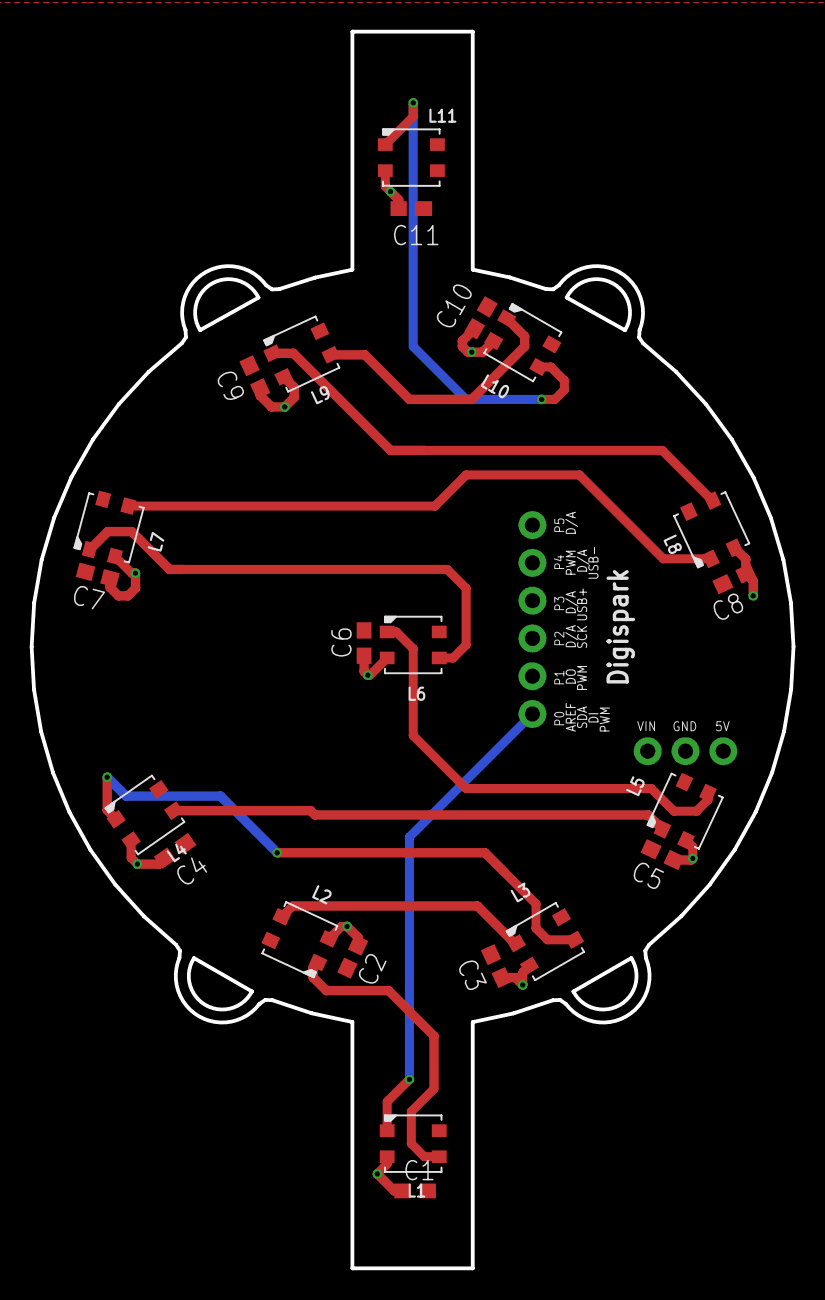
[picture p10: board EMF Broach V1.0.brd from above]

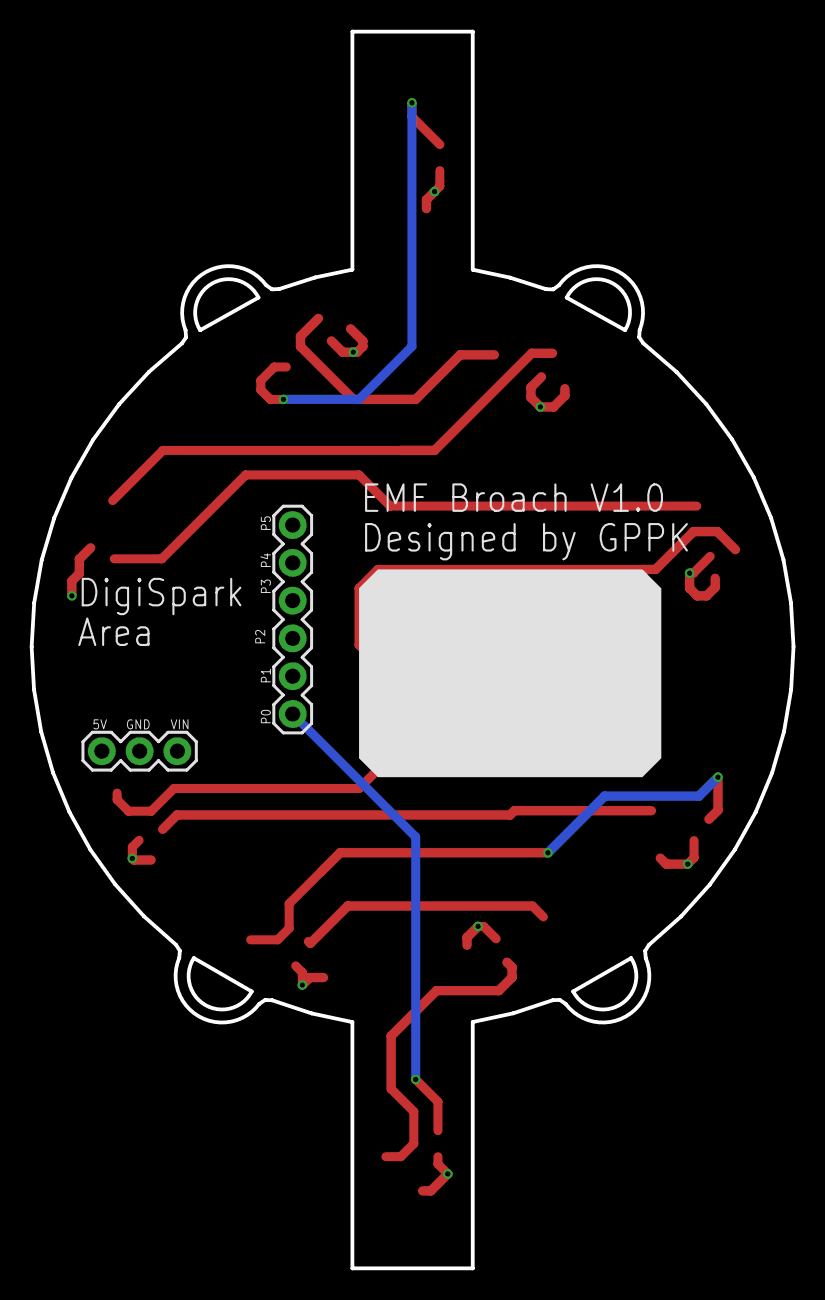
[picture p11: board EMF Broach V1.0.brd from below]

Board: 2 copper layers, 51.2 x 83.1 mm, 24 parts (2 on the bottom side), 13 nets.
