gppk/EMF-Logo-Broach/(commit log)

2019-12-24 First Test Boards for manufacturing
    First set of boards to be manufactured for testing. Includes LEDs, wiring & Digispark connector. Will be used to test spacing of everything & that it actually works.
    [EMF Broach BOM V1.0.xls, EMF Broach V1.0.brd, EMF Broach V1.0.sch]
2020-01-16 Moved Hardware to specific folder
    [EMF Broach BOM V1.0.xls, EMF Broach V2.0.brd, EMF Broach V2.0.sch]
2020-01-16 First stab at software
    Generic arduino neopixel with flameflicker code.
2020-01-30 Mostly finished V2
    Moved battery holder terminal and rerouted all LEDs to correct datasheet
    [EMF Broach V2.0.brd, EMF Broach V2.0.sch]
2022-04-12 Updated using reference design
    Old version didnt work. New version is very close to uploaded neopixel reference design.
    - More LEDs, tested on debug circuit.
    - Added 470 ohm resistor as per best practice
    - Needs routing.
    [Adafruit NeoPixel Ring 16 B.brd, Adafruit NeoPixel Ring 16 B.sch, EMF Broach.brd, EMF Broach.sch]
2022-04-12 Routing complete
    Had to fix some nets on sch as well. GND/power that was overlayed but not conencted etc.
    [EMF Broach.brd, EMF Broach.sch]
2022-04-13 fixed ERC/DRC
    fixed up the ERC/DRC. Haven't actually run on a board house one yet, probably mostly fine.
    [EMF Broach.brd, EMF Broach.sch]
2022-04-13 Alexs Changes.
    [EMF Broach.brd, EMF Broach.sch]
2022-04-14 Sent to fab
    [EMF Broach.brd]
2022-05-11 Update EMF-Broach-Firmware.ino
    Final firmware that works well with the 9V battery and digispark. brightness can be upped to 150 and it works but 100 seems like a good compromise/
2022-05-11 Removal of legacy files
    a cleanup commit, removing some no longer useful files.
    [Adafruit NeoPixel Ring 16 B.brd, Adafruit NeoPixel Ring 16 B.sch, EMF Broach BOM V1.0.xls]
2022-05-11 Gerber files for V3.0 - Sent for manufacturing
    Manufactured gerber files. Sent to fab as V3.0 board run.
    [EMF Broach.GBL, EMF Broach.GBO, EMF Broach.GBP, EMF Broach.GBS, EMF Broach.GKO, EMF Broach.GTL, EMF Broach.GTO, EMF Broach.GTP]
2022-05-11 Solder Stencil Files
    I have created a 3D printable solder stencil for this project using https://github.com/kirberich/gerber_to_scad
    [output.scad, pcb-stencil.3mf]
2022-05-11 Added printable PDFs
    schematic and pcb pdfs
2022-05-13 Create Diffuser Case.3mf
    Added diffuser case 3d printing files
    [Diffuser Case.3mf]
